asare-21/maame-air/fab/MaameDrone_V1.0_renders.pdf

## MaameDrone V1.0: top

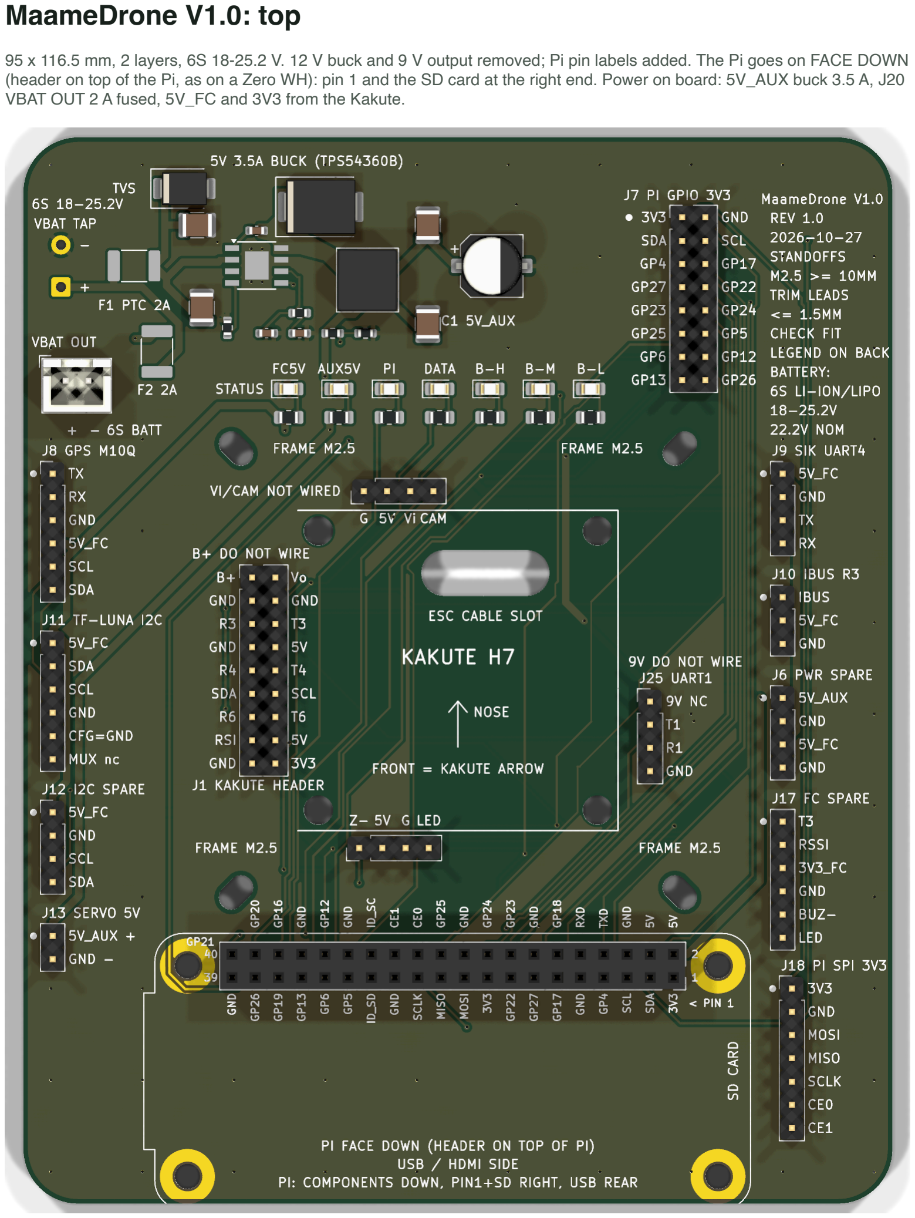
[picture p4: page 1]

95 x 116.5 mm, 2 layers, 6S 18-25.2 V. 12 V buck and 9 V output removed; Pi pin labels added. The Pi goes on FACE DOWN (header on top of the Pi, as on a Zero WH): pin 1 and the SD card at the right end. Power on board: 5V_AUX buck 3.5 A, J20 VBAT OUT 2 A fused, 5V_FC and 3V3 from the Kakute.

## MaameDrone V1.0: 3D view

Parts as fitted by JLCPCB: 5 V buck, status LEDs, Kakute headers, Pi socket.

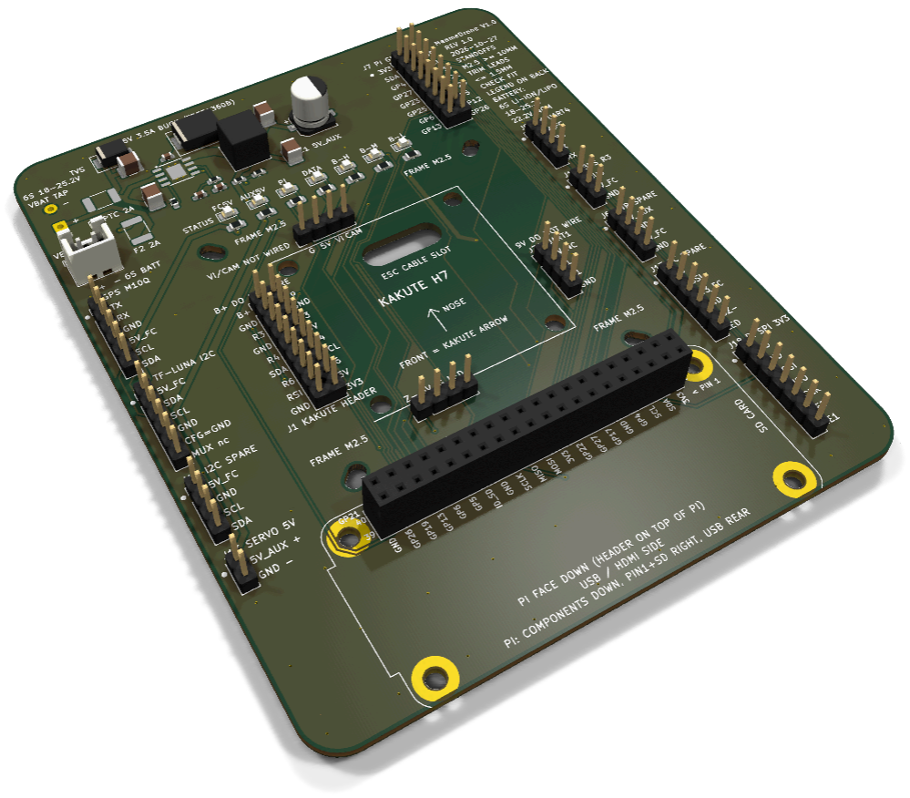
[picture p5: figure]

## MaameDrone V1.0: bottom

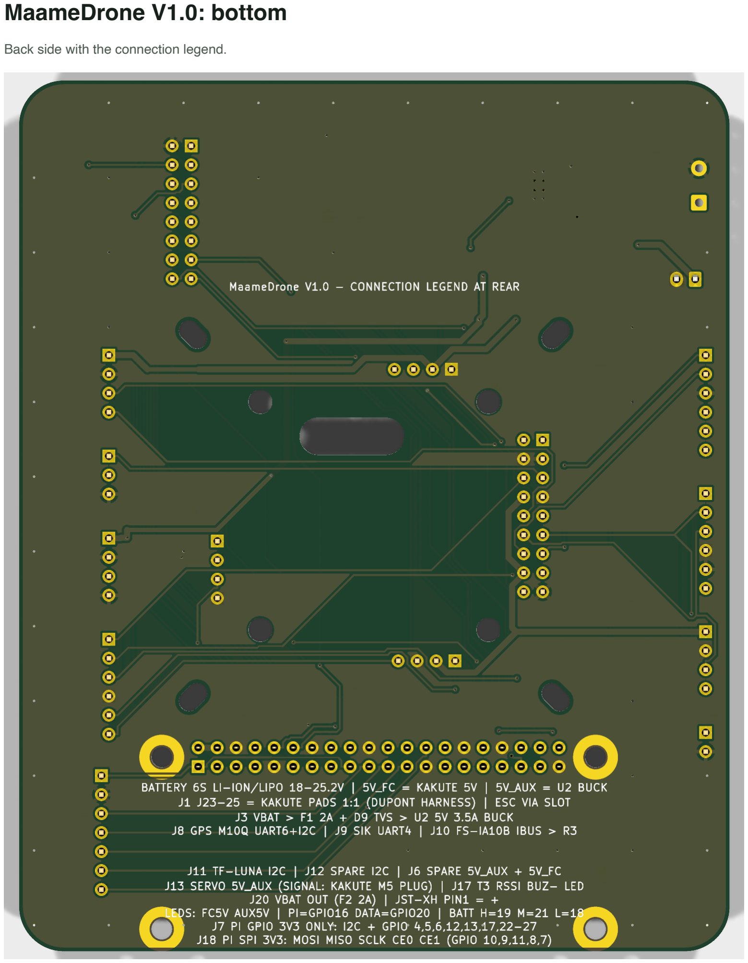
[picture p6: page 3]

Back side with the connection legend.
