asare-21/maame-air/fab/MaameDrone_V1.0_render_3d_angle.png

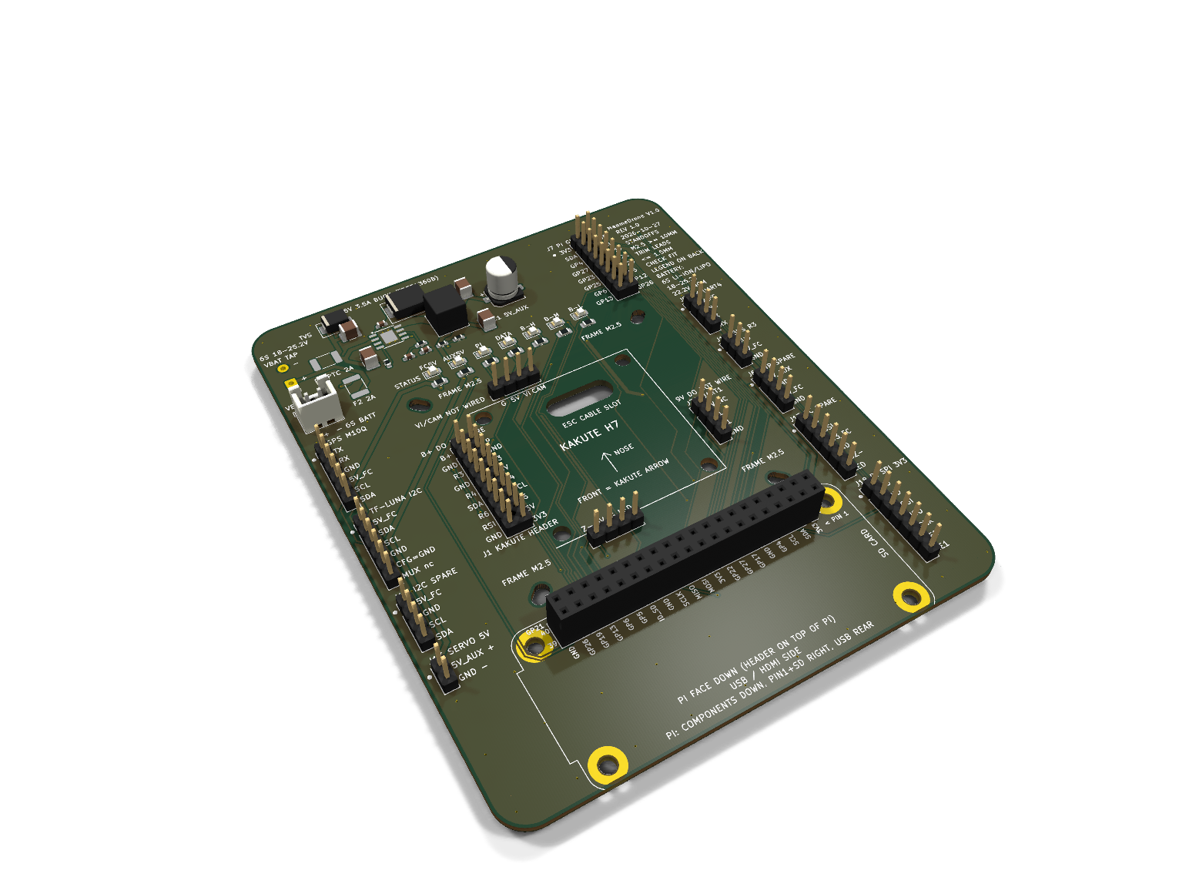
fab/MaameDrone_V1.0_render_3d_angle.png
