asare-21/maame-air/fab/MaameDrone_V1.0_render_bottom.png

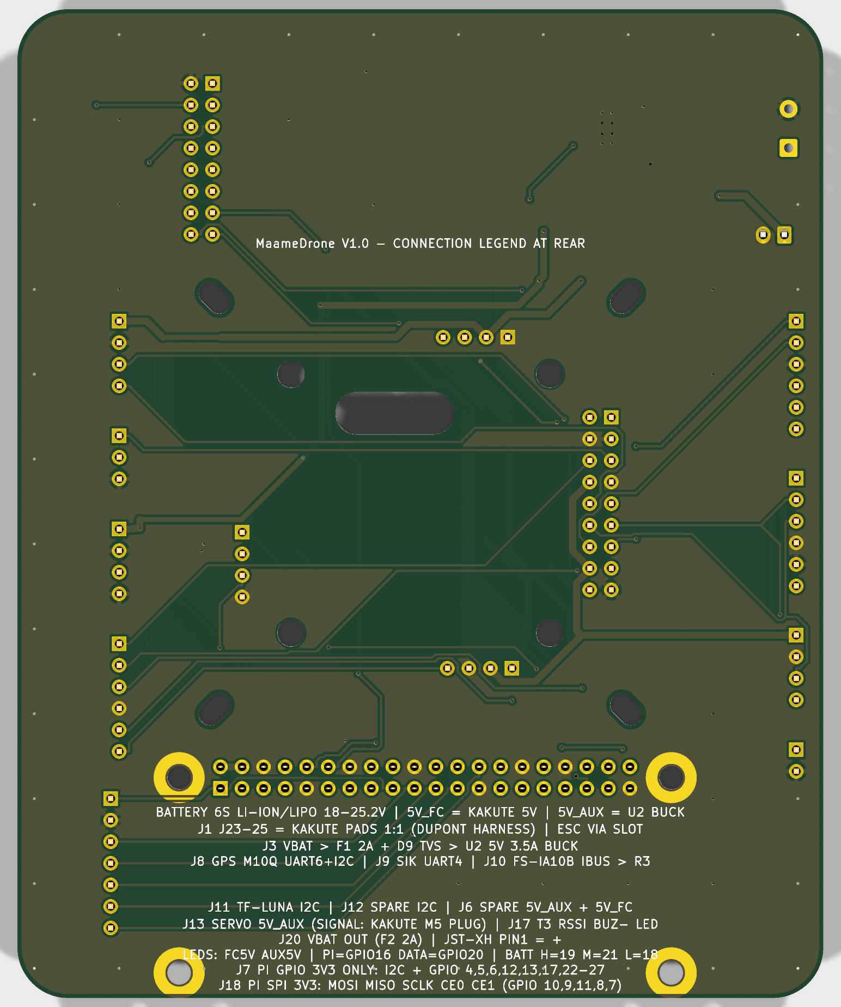
fab/MaameDrone_V1.0_render_bottom.png
