asare-21/maame-air/fab/MaameDrone_V1.0_render_top.png

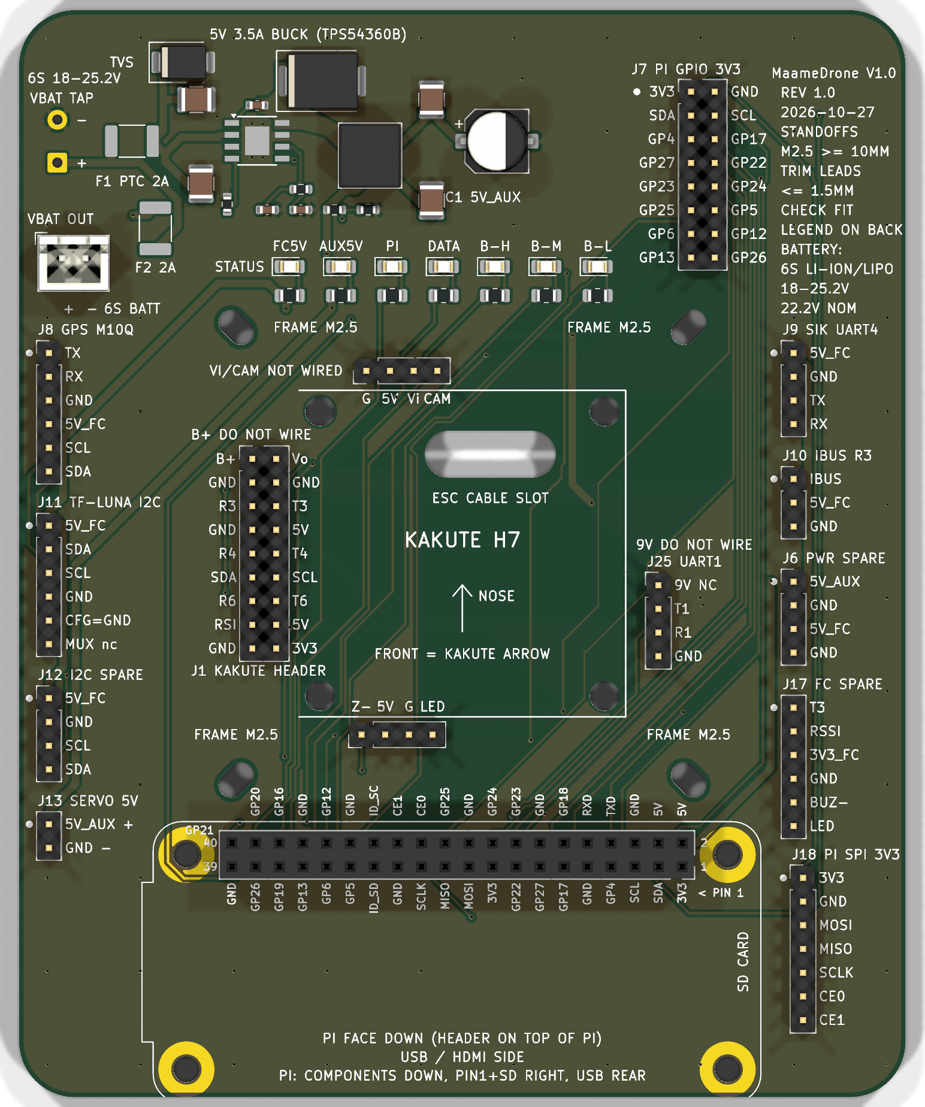
fab/MaameDrone_V1.0_render_top.png
