asare-21/maame-air/maame_carrier_placement_draft.png

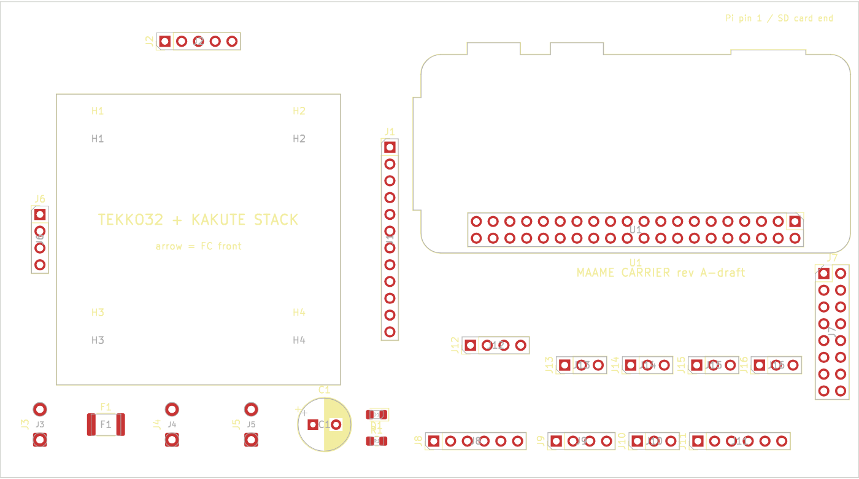
maame_carrier_placement_draft.png
