asare-21/maame-air/fab/MaameDrone_V1.0_BOM_JLC.csv

Comment | Designator | Footprint | LCSC Part #
470uF 16V SMD electrolytic (LCSC C22383803) | C1 | CP_Elec_6.3x7.7 | C22383803
2.2uF 100V X7R 1210 (VIN) | C2,C3 | C_1210_3225Metric | C153036
100nF 50V 0603 (BOOT) | C4 | C_0603_1608Metric | C14663
6.8nF 50V 0603 (COMP) | C5 | C_0603_1608Metric | C1631
47uF 10V X7R 1210 (OUT) | C6,C7 | C_1210_3225Metric | C84494
39pF 50V C0G 0603 (COMP) | C8 | C_0603_1608Metric | C107049
Green 0805: 5V_AUX on | D1,D2,D3,D5 | LED_0805_2012Metric_Pad1.15x1.40mm_HandSolder | C2297
Yellow 0805: data (GPIO20) | D4,D6 | LED_0805_2012Metric_Pad1.15x1.40mm_HandSolder | C2296
Red 0805: battery low (GPIO18) | D7 | LED_0805_2012Metric_Pad1.15x1.40mm_HandSolder | C84256
B560C 60V 5A Schottky SMC | D8 | D_SMC | C85100
SMBJ30A TVS 30V standoff, 48.4V clamp | D9 | D_SMB | C113998
PTC fuse 1812 30V 2A hold 4A trip (BSMD1812-200-30V, LCSC C960026) | F1,F2 | Fuse_1812_4532Metric_Pad1.30x3.40mm_HandSolder | C960026
8.2uH 8.4A Coilcraft XAL6060-822MEC | L1 | L_Coilcraft_XAL6060-XXX | C19191627
1k 0805 | R1,R2 | R_0805_2012Metric_Pad1.20x1.40mm_HandSolder | C17513
330R 0805 | R3,R4,R5,R6 | R_0805_2012Metric_Pad1.20x1.40mm_HandSolder | C17630
390R 0805 | R7 | R_0805_2012Metric_Pad1.20x1.40mm_HandSolder | C17655
162k 1% 0603 (RT, 600 kHz) | R8 | R_0603_1608Metric | C227607
13k 1% 0603 (COMP) | R9 | R_0603_1608Metric | C22797
53.6k 1% 0603 (FB top) | R10 | R_0603_1608Metric | C23074
10k 1% 0603 (FB bottom) | R11 | R_0603_1608Metric | C25804
TPS54360BDDAR 60V 3.5A buck | U2 | TI_SO-PowerPAD-8_ThermalVias | C524806
