asare-21/maame-air/maame_carrier.pdf

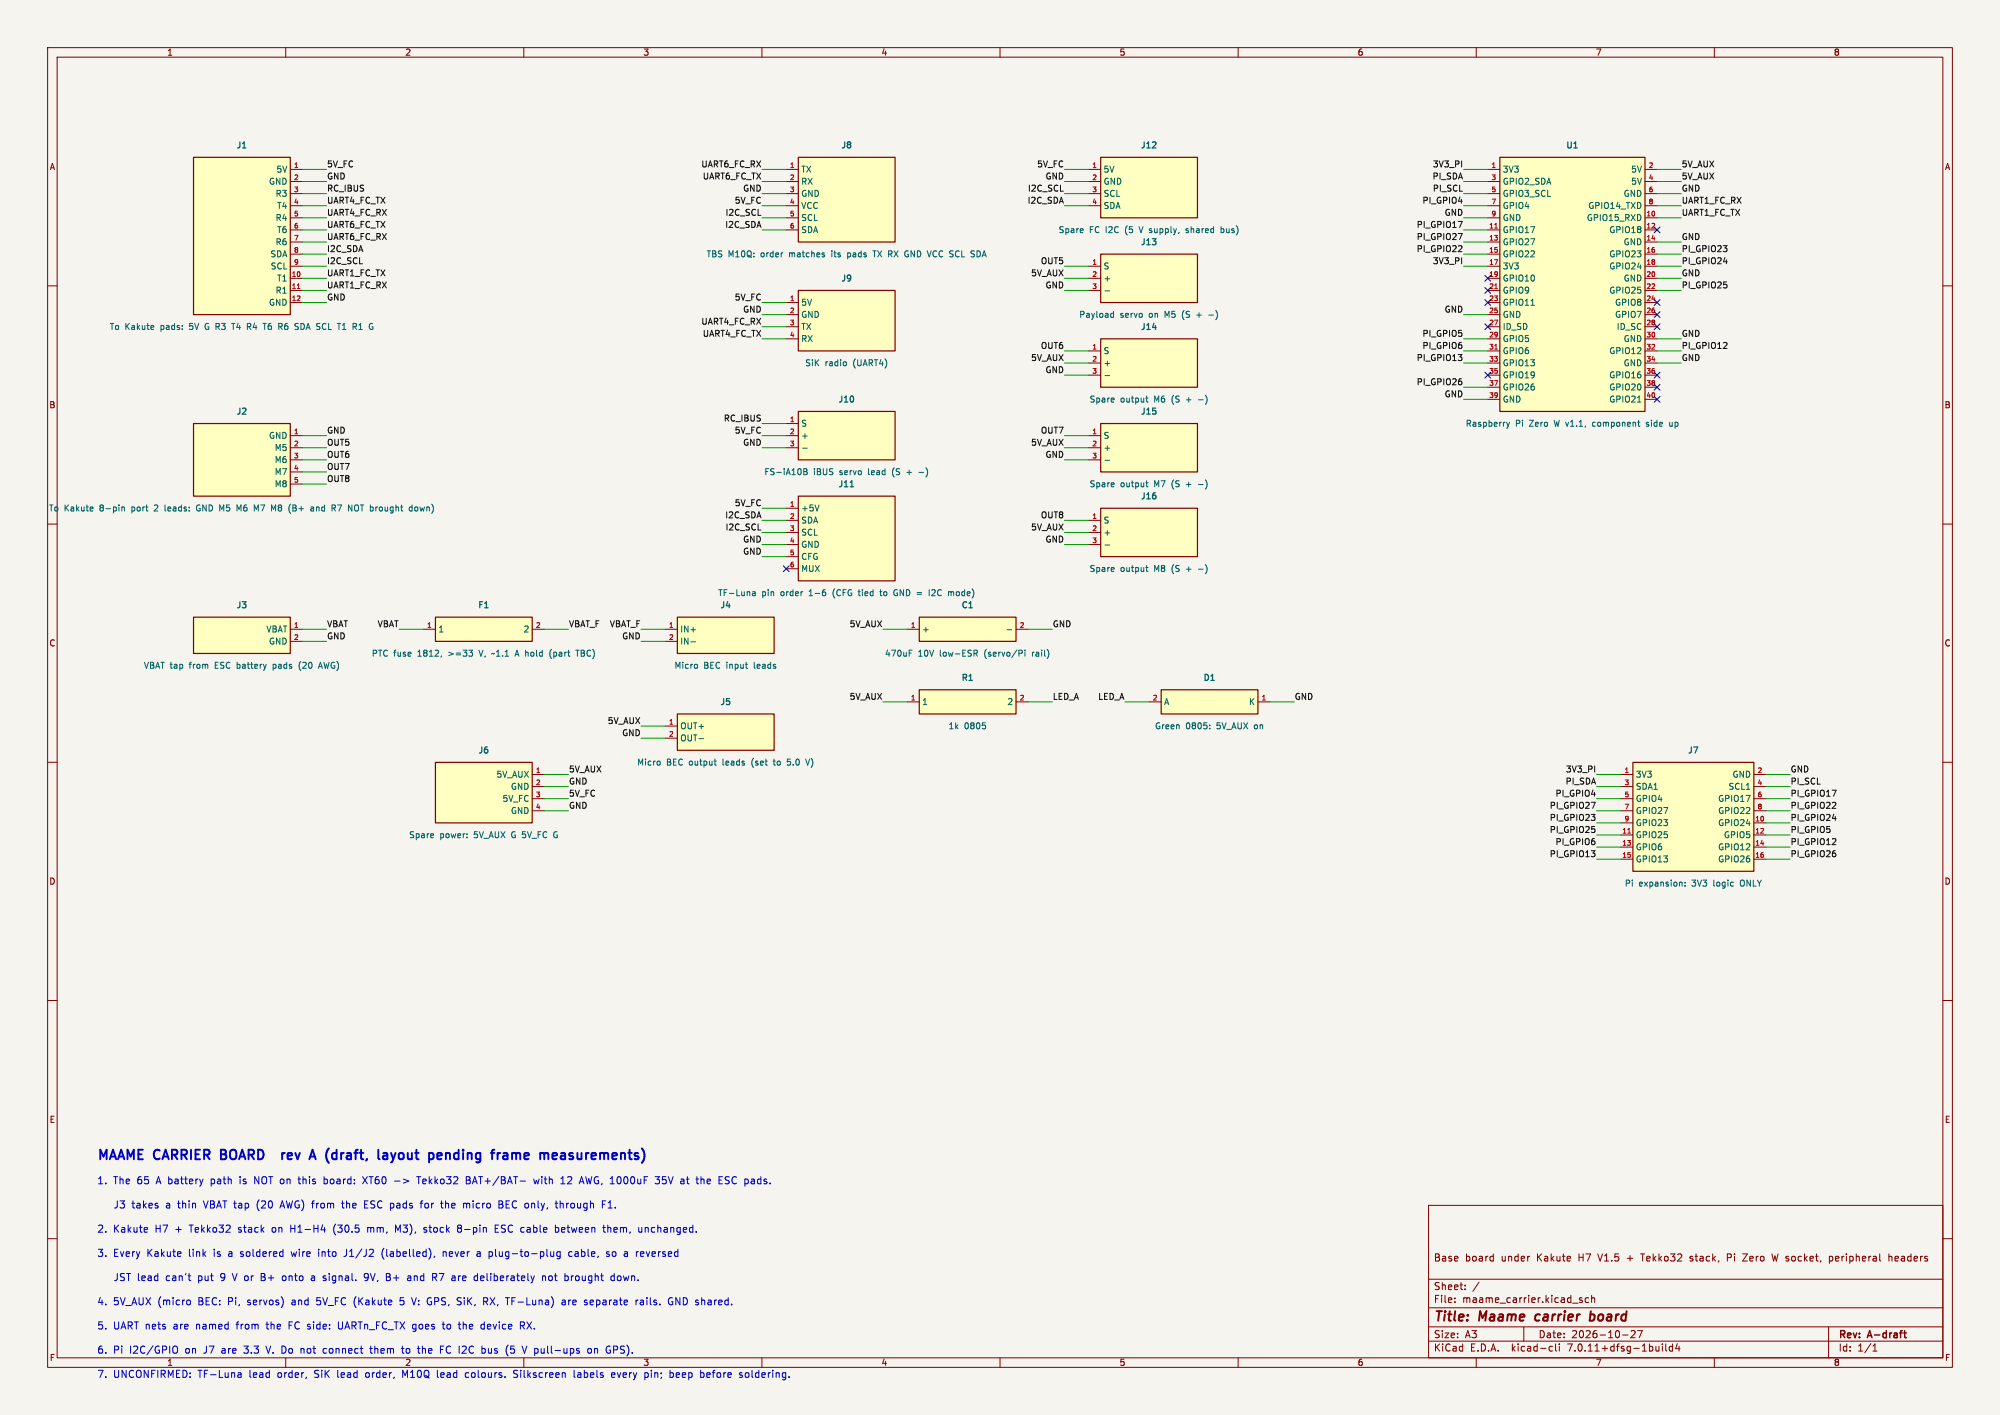
[picture p11: page 1]

5V 1 T1 10 R1 11 GND 12 GND 2 R3 3 T4 4 R4 5 T6 6 R6 7 SDA 8 SCL 9 J1 To Kakute pads: 5V G R3 T4 R4 T6 R6 SDA SCL T1 R1 G

Id: 1/1 Title: Maame carrier board
