asare-21/maame-air/plate_template/maame_carrier_plate_template_1to1.pdf

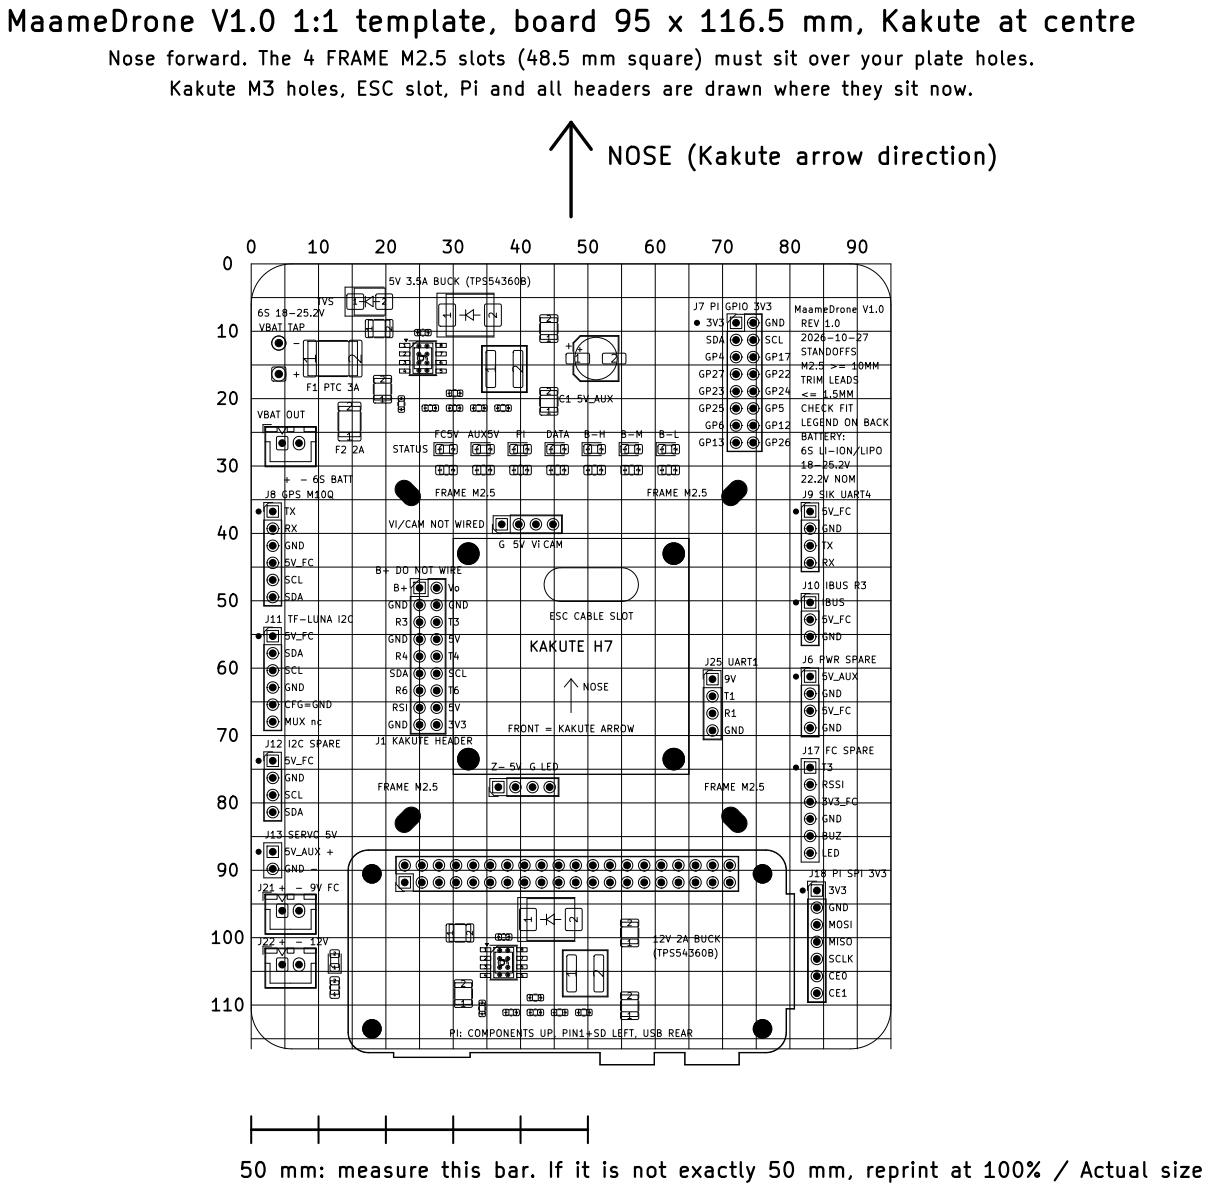
[picture p12: page 1]

MaameDrone V1.0 1:1 template, board 95 x 116.5 mm, Kakute at centre
FC5V 5V 3.5A BUCK (TPS54360B) AUX5VZ-

Nose forward. The 4 FRAME M2.5 slots (48.5 mm square) must sit over your plate holes.
Kakute M3 holes, ESC slot, Pi and all headers are drawn where they sit now.

NOSE (Kakute arrow direction)

F2 | 2A | | | | | | | | | | H7 | | SDA GP4 GP27 GP23 GP25 GP6 GP13 KAKUTE | | BATTERY: 6S LI-ION/LIPO
J8 GPS M10Q | - | | | | FRAME M2.5 | | | | | 2 | FRAME M2.5 | | 4 1 | | 18-25.2V 22.2V NOM J9 SIK UART4

3 4 | 5V_FC | | | | | | 9 1 5V5VPI G G | ESC CABLE SLOT B-H CAM | | | B-M | B-L | FRAME M2.5 | | 3 4 | TXRX

6S BATT TXRXGND | | B+ DO NOT WIRE | VI/CAM NOT | | WIRED | | | | | | | | | | 1 | 5V_FC GND

5 | SCL SDA 5V_FC | | | | | | | | | | | | | | J10 | IBUS R3

1 SDA SCL GND | R4 | 7 8 9 10 | 5V T4 | J25 | UART1 | 3 J6 PWR SPARE

3 4 | | | | SDA R6 RSI GND | 11 12 13 14 | SCL T6 | | | 1 | 9V | | | 1 | 5V_AUX GND

5 6 | CFG=GND MUX nc 5V_FC | | | | 15 16 17 18 | | FRONT = | KAKUTE ARROW | 3 | T1R1GND | | 3 4 | | 5V_FC GND

J12 | I2C SPARE | | J1 | KAKUTE HEADER | | | | | | | J17 | FC SPARE

SCL SDA 5V_AUX + | | | | | | | | | | | | 4 5 | GND BUZ-

GND - | | | | | | | | | | | | | 6 | LED

-9V FC | | | 3 5 | 7 9 | 11 13 | 15 17 | 19 21 | 23 25 | 27 29 | 31 33 | 35 37 | 39 | J18 PI SPI 3V3

2 3 | 3V3 GND MOSI MISO

J22 + | -12V | (TPS54360B) | 4 5 | SCLK

50 mm: measure this bar. If it is not exactly 50 mm, reprint at 100% / Actual size
