asare-21/maame-air/(list of files, drawings)

Other design files:
route/maame_carrier.dsn
