asare-21/maame-air/maame_carrier.kicad_pcb

## KiCad design maame_carrier.kicad_pcb (2026-10-28)

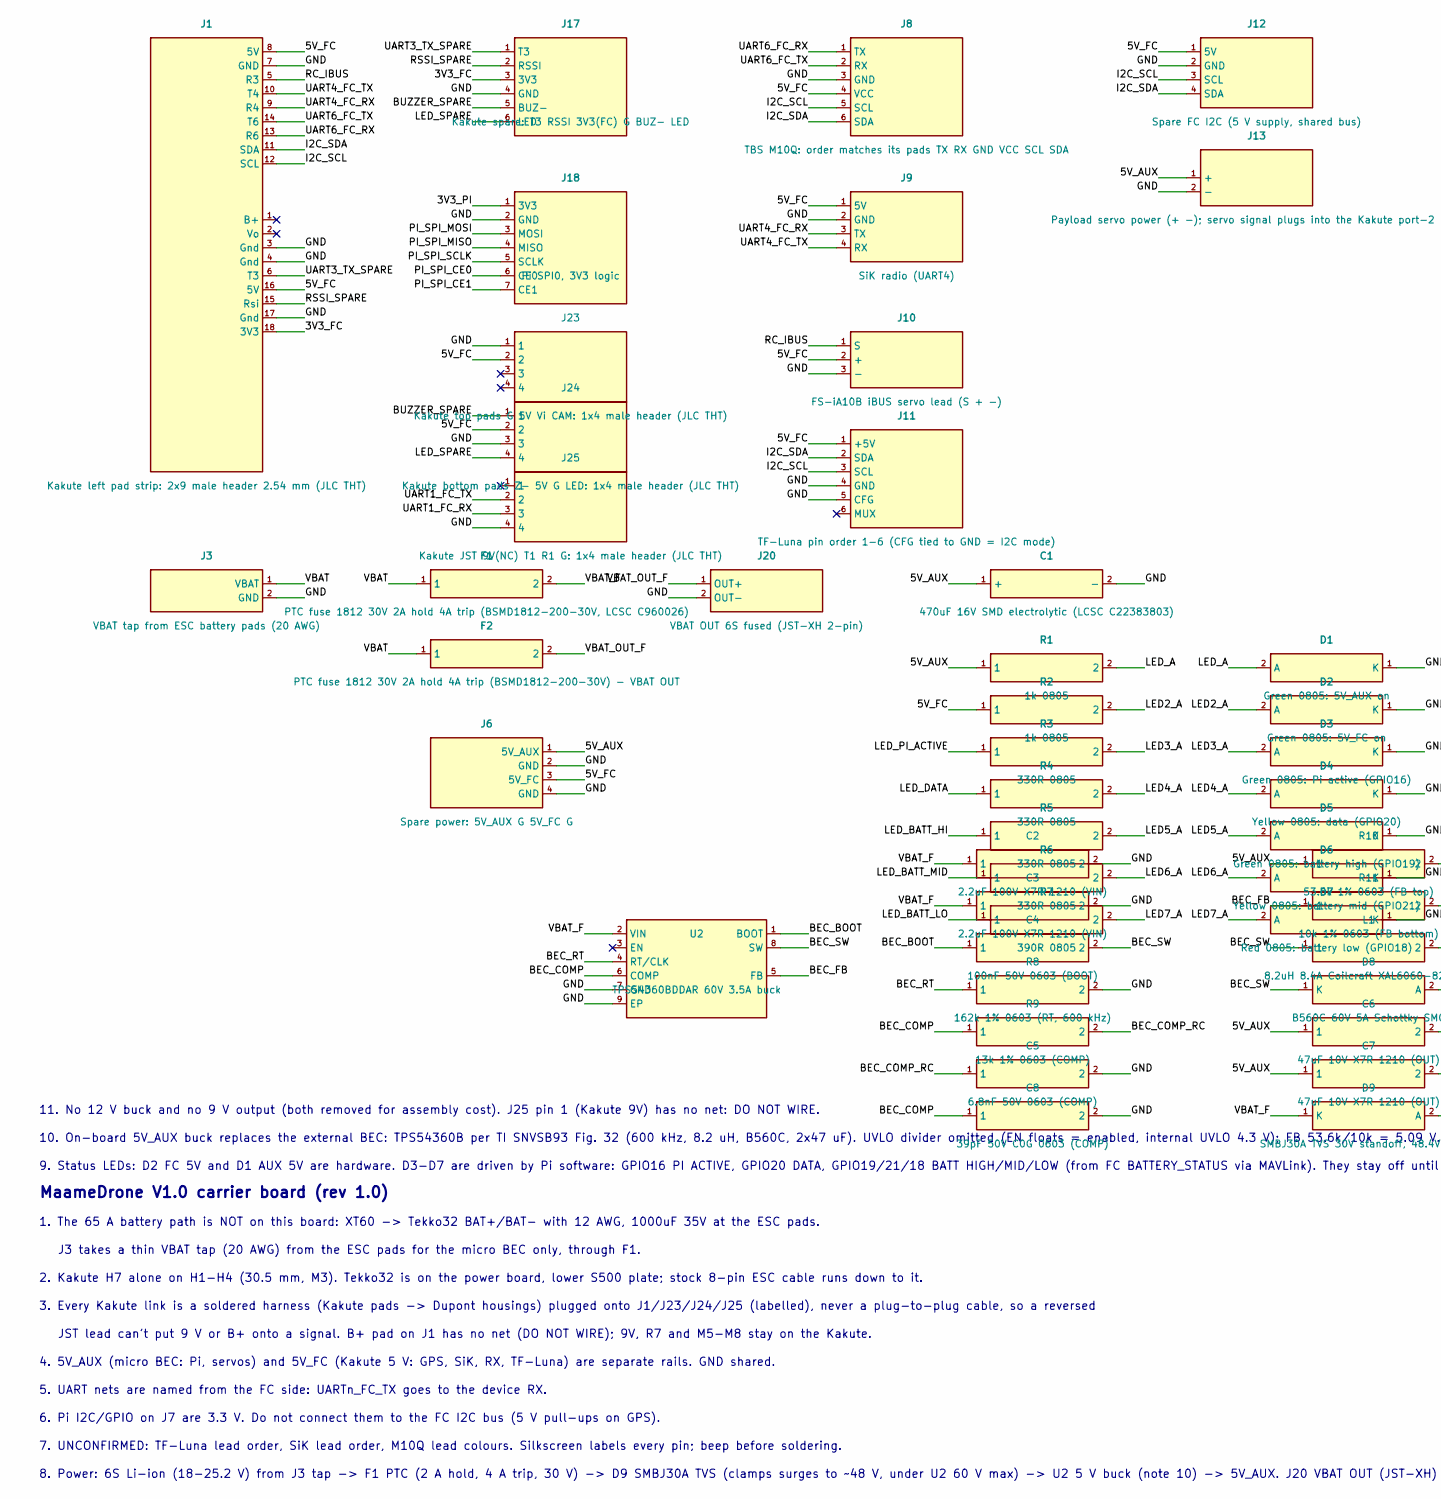
[picture p13: schematic maame_carrier.kicad_sch, MaameDrone V1.0, part in row 1, column 1]

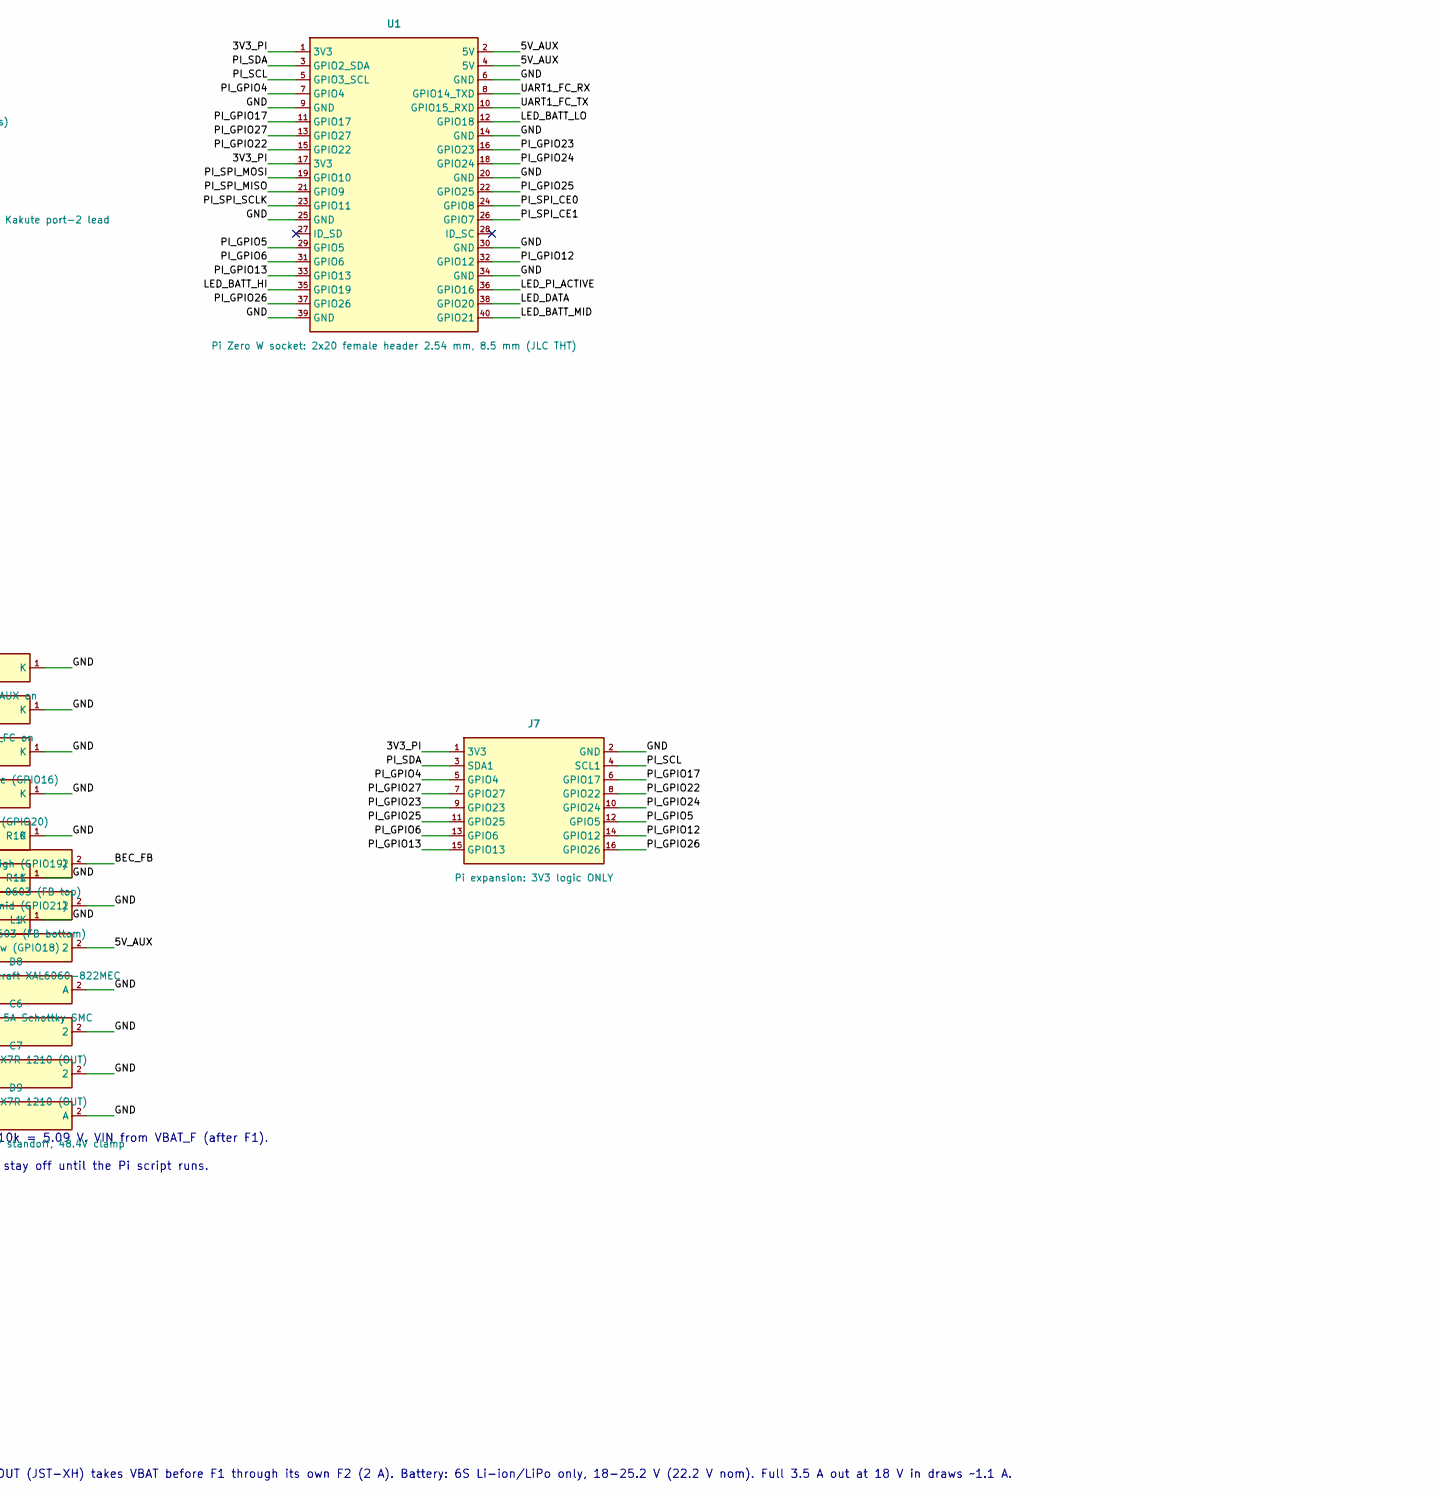
[picture p14: schematic maame_carrier.kicad_sch, MaameDrone V1.0, part in row 1, column 2]

Parts:
C1: 470uF 16V SMD electrolytic (LCSC C22383803); CP_Elec_6.3x7.7; LCSC C22383803
C2, C3: 2.2uF 100V X7R 1210 (VIN); C_1210_3225Metric; LCSC C153036
C4: 100nF 50V 0603 (BOOT); C_0603_1608Metric; LCSC C14663
C5: 6.8nF 50V 0603 (COMP); C_0603_1608Metric; LCSC C1631
C6, C7: 47uF 10V X7R 1210 (OUT); C_1210_3225Metric; LCSC C84494
C8: 39pF 50V C0G 0603 (COMP); C_0603_1608Metric; LCSC C107049
D1: Green 0805: 5V_AUX on; LED_0805_2012Metric_Pad1.15x1.40mm_HandSolder; LCSC C2297
D2: Green 0805: 5V_FC on; LED_0805_2012Metric_Pad1.15x1.40mm_HandSolder; LCSC C2297
D3: Green 0805: Pi active (GPIO16); LED_0805_2012Metric_Pad1.15x1.40mm_HandSolder; LCSC C2297
D4: Yellow 0805: data (GPIO20); LED_0805_2012Metric_Pad1.15x1.40mm_HandSolder; LCSC C2296
D5: Green 0805: battery high (GPIO19); LED_0805_2012Metric_Pad1.15x1.40mm_HandSolder; LCSC C2297
D6: Yellow 0805: battery mid (GPIO21); LED_0805_2012Metric_Pad1.15x1.40mm_HandSolder; LCSC C2296
D7: Red 0805: battery low (GPIO18); LED_0805_2012Metric_Pad1.15x1.40mm_HandSolder; LCSC C84256
D8: B560C 60V 5A Schottky SMC; D_SMC; LCSC C85100
D9: SMBJ30A TVS 30V standoff, 48.4V clamp; D_SMB; LCSC C113998
F1, F2: PTC fuse 1812 30V 2A hold 4A trip (BSMD1812-200-3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; Fuse_1812_4532Metric_Pad1.30x3.40mm_HandSolder; LCSC C960026
J1: Kakute left pad strip: 2x9 male header 2.54 mm (J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; PinHeader_2x09_P2.54mm_Vertical; LCSC C42372517
J3: VBAT tap from ESC battery pads (20 AWG); SolderWire-0.5sqmm_1x02_P4.6mm_D0.9mm_OD2.1mm
J6: Spare power: 5V_AUX G 5V_FC G; PinHeader_1x04_P2.54mm_Vertical
J7: Pi expansion: 3V3 logic ONLY; PinHeader_2x08_P2.54mm_Vertical
J8: TBS M10Q: order matches its pads TX RX GND VCC SC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; PinHeader_1x06_P2.54mm_Vertical
J9: SiK radio (UART4); PinHeader_1x04_P2.54mm_Vertical
J10: FS-iA10B iBUS servo lead (S + -); PinHeader_1x03_P2.54mm_Vertical
J11: TF-Luna pin order 1-6 (CFG tied to GND = I2C mode); PinHeader_1x06_P2.54mm_Vertical
J12: Spare FC I2C (5 V supply, shared bus); PinHeader_1x04_P2.54mm_Vertical
J13: Payload servo power (+ -); servo signal plugs int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; PinHeader_1x02_P2.54mm_Vertical
J17: Kakute spare: T3 RSSI 3V3(FC) G BUZ- LED; PinHeader_1x06_P2.54mm_Vertical
J18: Pi SPI0, 3V3 logic; PinHeader_1x07_P2.54mm_Vertical
J20: VBAT OUT 6S fused (JST-XH 2-pin); JST_XH_B2B-XH-A_1x02_P2.50mm_Vertical
J23: Kakute top pads G 5V Vi CAM: 1x4 male header (JLC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; PinHeader_1x04_P2.54mm_Vertical; LCSC C32713270
J24: Kakute bottom pads Z- 5V G LED: 1x4 male header (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; PinHeader_1x04_P2.54mm_Vertical; LCSC C32713270
J25: Kakute JST 9V(NC) T1 R1 G: 1x4 male header (JLC T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; PinHeader_1x04_P2.54mm_Vertical; LCSC C32713270
L1: 8.2uH 8.4A Coilcraft XAL6060-822MEC; L_Coilcraft_XAL6060-XXX; LCSC C19191627
R1, R2: 1k 0805; R_0805_2012Metric_Pad1.20x1.40mm_HandSolder; LCSC C17513
R3, R4, R5, R6: 330R 0805; R_0805_2012Metric_Pad1.20x1.40mm_HandSolder; LCSC C17630
R7: 390R 0805; R_0805_2012Metric_Pad1.20x1.40mm_HandSolder; LCSC C17655
R8: 162k 1% 0603 (RT, 600 kHz); R_0603_1608Metric; LCSC C227607
R9: 13k 1% 0603 (COMP); R_0603_1608Metric; LCSC C22797
R10: 53.6k 1% 0603 (FB top); R_0603_1608Metric; LCSC C23074
R11: 10k 1% 0603 (FB bottom); R_0603_1608Metric; LCSC C25804
U1: Pi Zero W socket: 2x20 female header 2.54 mm, 8.5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; Pi_Zero_Socketed_FaceDown_MountingHoles; LCSC C5124634
U2: TPS54360BDDAR 60V 3.5A buck; TI_SO-PowerPAD-8_ThermalVias; LCSC C524806

Connections:
/3V3_FC: J1.18 (3V3), J17.3 (3V3)
/3V3_PI: J7.1 (3V3), J18.1 (3V3), U1.1 (3V3), U1.17 (3V3)
/5V_AUX: C1.1 (+), C6.1, C7.1, J6.1 (5V_AUX), J13.1 (+), L1.2, R1.1, R10.1, U1.2 (5V), U1.4 (5V)
/5V_FC: J1.8 (5V), J1.16 (5V), J6.3 (5V_FC), J8.4 (VCC), J9.1 (5V), J10.2 (+), J11.1 (+5V), J12.1 (5V), J23.2, J24.2, R2.1
/BEC_BOOT: C4.1, U2.1 (BOOT)
/BEC_COMP: C8.1, R9.1, U2.6 (COMP)
/BEC_COMP_RC: C5.1, R9.2
/BEC_FB: R10.2, R11.1, U2.5 (FB)
/BEC_RT: R8.1, U2.4 (RT/CLK)
/BEC_SW: C4.2, D8.1 (K), L1.1, U2.8 (SW)
/BUZZER_SPARE: J17.5 (BUZ-), J24.1
/GND: C1.2 (-), C2.2, C3.2, C5.2, C6.2, C7.2, C8.2, D1.1 (K), D2.1 (K), D3.1 (K), D4.1 (K), D5.1 (K), D6.1 (K), D7.1 (K), D8.2 (A), D9.2 (A), J1.3 (Gnd), J1.4 (Gnd), J1.7 (GND), J1.17 (Gnd), J3.2 (GND), J6.2 (GND), J6.4 (GND), J7.2 (GND), J8.3 (GND), J9.2 (GND), J10.3 (-), J11.4 (GND), J11.5 (CFG), J12.2 (GND), J13.2 (-), J17.4 (GND), J18.2 (GND), J20.2 (OUT-), J23.1, J24.3, J25.4, R8.2, R11.2, U1.6 (GND), U1.9 (GND), U1.14 (GND), U1.20 (GND), U1.25 (GND), U1.30 (GND), U1.34 (GND), U1.39 (GND), U2.7 (GND), U2.9 (EP)
/I2C_SCL: J1.12 (SCL), J8.5 (SCL), J11.3 (SCL), J12.3 (SCL)
/I2C_SDA: J1.11 (SDA), J8.6 (SDA), J11.2 (SDA), J12.4 (SDA)
/LED2_A: D2.2 (A), R2.2
/LED3_A: D3.2 (A), R3.2
/LED4_A: D4.2 (A), R4.2
/LED5_A: D5.2 (A), R5.2
/LED6_A: D6.2 (A), R6.2
/LED7_A: D7.2 (A), R7.2
/LED_A: D1.2 (A), R1.2
/LED_BATT_HI: R5.1, U1.35 (GPIO19)
/LED_BATT_LO: R7.1, U1.12 (GPIO18)
/LED_BATT_MID: R6.1, U1.40 (GPIO21)
/LED_DATA: R4.1, U1.38 (GPIO20)
/LED_PI_ACTIVE: R3.1, U1.36 (GPIO16)
/LED_SPARE: J17.6 (LED), J24.4
/PI_GPIO4: J7.5 (GPIO4), U1.7 (GPIO4)
/PI_GPIO5: J7.12 (GPIO5), U1.29 (GPIO5)
/PI_GPIO6: J7.13 (GPIO6), U1.31 (GPIO6)
/PI_GPIO12: J7.14 (GPIO12), U1.32 (GPIO12)
/PI_GPIO13: J7.15 (GPIO13), U1.33 (GPIO13)
/PI_GPIO17: J7.6 (GPIO17), U1.11 (GPIO17)
/PI_GPIO22: J7.8 (GPIO22), U1.15 (GPIO22)
/PI_GPIO23: J7.9 (GPIO23), U1.16 (GPIO23)
/PI_GPIO24: J7.10 (GPIO24), U1.18 (GPIO24)
/PI_GPIO25: J7.11 (GPIO25), U1.22 (GPIO25)
/PI_GPIO26: J7.16 (GPIO26), U1.37 (GPIO26)
/PI_GPIO27: J7.7 (GPIO27), U1.13 (GPIO27)
/PI_SCL: J7.4 (SCL1), U1.5 (GPIO3_SCL)
/PI_SDA: J7.3 (SDA1), U1.3 (GPIO2_SDA)
/PI_SPI_CE0: J18.6 (CE0), U1.24 (GPIO8)
/PI_SPI_CE1: J18.7 (CE1), U1.26 (GPIO7)
/PI_SPI_MISO: J18.4 (MISO), U1.21 (GPIO9)
/PI_SPI_MOSI: J18.3 (MOSI), U1.19 (GPIO10)
/PI_SPI_SCLK: J18.5 (SCLK), U1.23 (GPIO11)
/RC_IBUS: J1.5 (R3), J10.1 (S)
/RSSI_SPARE: J1.15 (Rsi), J17.2 (RSSI)
/UART1_FC_RX: J25.3, U1.8 (GPIO14_TXD)
/UART1_FC_TX: J25.2, U1.10 (GPIO15_RXD)
/UART3_TX_SPARE: J1.6 (T3), J17.1 (T3)
/UART4_FC_RX: J1.9 (R4), J9.3 (TX)
/UART4_FC_TX: J1.10 (T4), J9.4 (RX)
/UART6_FC_RX: J1.13 (R6), J8.1 (TX)
/UART6_FC_TX: J1.14 (T6), J8.2 (RX)
/VBAT: F1.1, F2.1, J3.1 (VBAT)
/VBAT_F: C2.1, C3.1, D9.1 (K), F1.2, U2.2 (VIN)
/VBAT_OUT_F: F2.2, J20.1 (OUT+)

Notes on the sheet:
J3 takes a thin VBAT tap (20 AWG) from the ESC pads for the micro BEC only, through F1.
MaameDrone V1.0 carrier board (rev 1.0)
5. UART nets are named from the FC side: UARTn_FC_TX goes to the device RX.
6. Pi I2C/GPIO on J7 are 3.3 V. Do not connect them to the FC I2C bus (5 V pull-ups on GPS).
3. Every Kakute link is a soldered harness (Kakute pads -> Dupont housings) plugged onto J1/J23/J24/J25 (labelled), never a plug-to-plug cable, so a reversed
1. The 65 A battery path is NOT on this board: XT60 -> Tekko32 BAT+/BAT- with 12 AWG, 1000uF 35V at the ESC pads.
4. 5V_AUX (micro BEC: Pi, servos) and 5V_FC (Kakute 5 V: GPS, SiK, RX, TF-Luna) are separate rails. GND shared.
8. Power: 6S Li-ion (18-25.2 V) from J3 tap -> F1 PTC (2 A hold, 4 A trip, 30 V) -> D9 SMBJ30A TVS (clamps surges to ~48 V, under U2 60 V max) -> U2 5 V buck (note 10) -> 5V_AUX. J20 VBAT OUT (JST-XH) takes VBAT before F1 through its own F2 (2 A). Battery: 6S Li-ion/LiPo only, 18-25.2 V (22.2 V nom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
7. UNCONFIRMED: TF-Luna lead order, SiK lead order, M10Q lead colours. Silkscreen labels every pin; beep before soldering.
2. Kakute H7 alone on H1-H4 (30.5 mm, M3). Tekko32 is on the power board, lower S500 plate; stock 8-pin ESC cable runs down to it.
JST lead can't put 9 V or B+ onto a signal. B+ pad on J1 has no net (DO NOT WIRE); 9V, R7 and M5-M8 stay on the Kakute.
9. Status LEDs: D2 FC 5V and D1 AUX 5V are hardware. D3-D7 are driven by Pi software: GPIO16 PI ACTIVE, GPIO20 DATA, GPIO19/21/18 BATT HIGH/MID/LOW (from FC BATTERY_STATUS via MAVLink). They stay off until the Pi script runs.
10. On-board 5V_AUX buck replaces the external BEC: TPS54360B per TI SNVSB93 Fig. 32 (600 kHz, 8.2 uH, B560C, 2x47 uF). UVLO divider omitted (EN floats = enabled, internal UVLO 4.3 V); FB 53.6k/10k = 5.09 V. VIN from VBAT_F (after F1).
11. No 12 V buck and no 9 V output (both removed for assembly cost). J25 pin 1 (Kakute 9V) has no net: DO NOT WIRE.

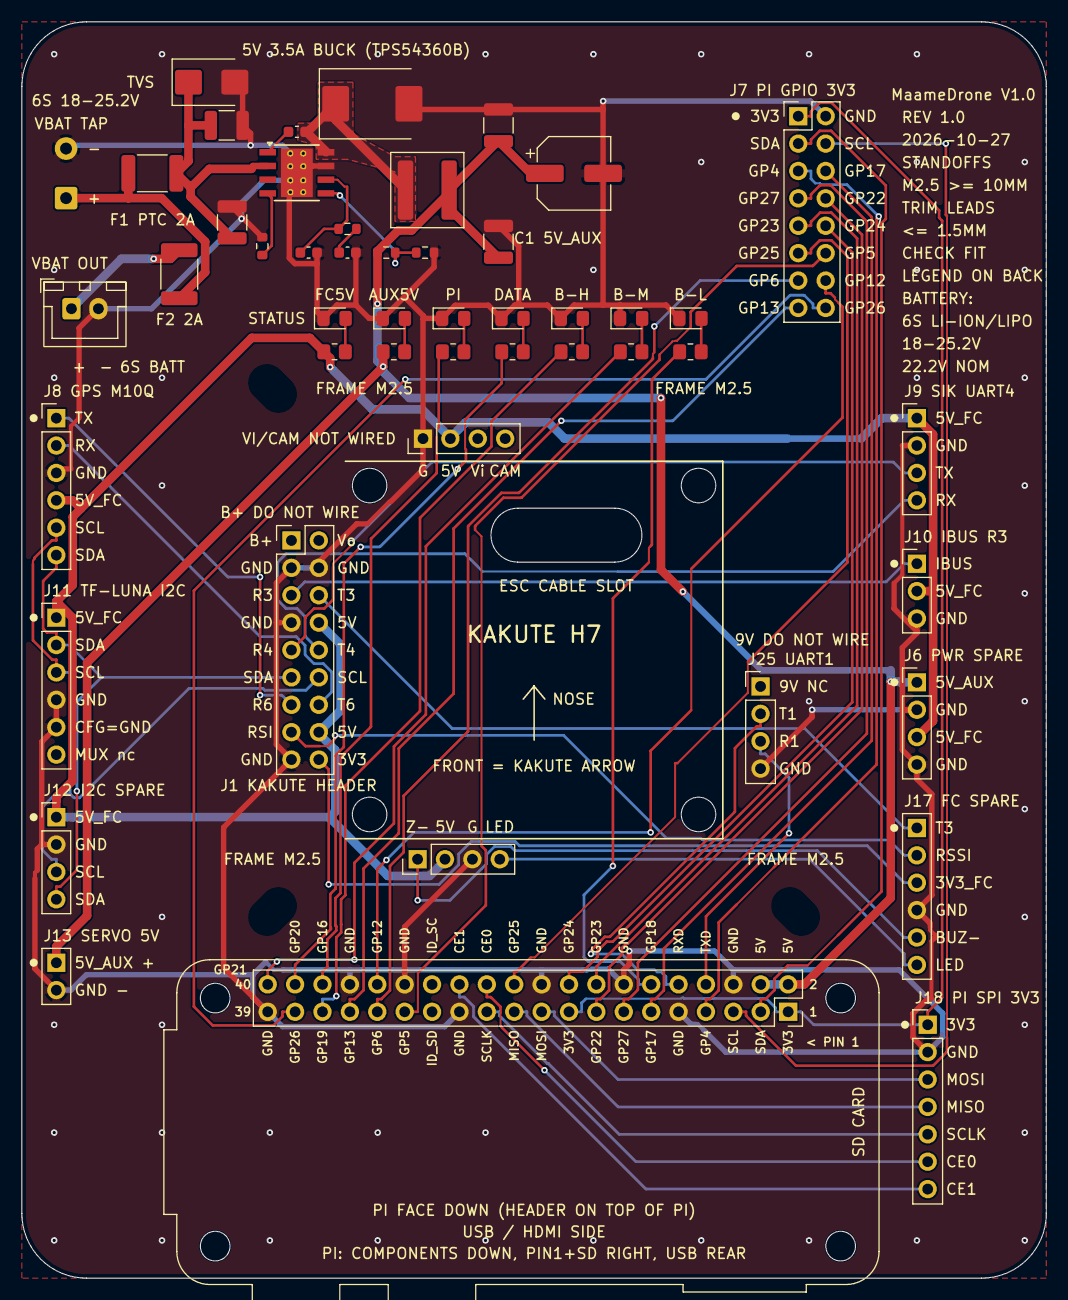
[picture p15: board maame_carrier.kicad_pcb from above]

Board: 2 copper layers, 95.0 x 116.5 mm, 57 parts (0 on the bottom side), 58 nets.

Other parts of the board:
H1, H2, H3, H4: M3 FC hole; MountingHole_3.2mm_M3
H5, H6, H7, H8: M2.5 frame mount, 48.5 mm square, radial slot; MountingHole_2.7mm_M2.5
