asare-21/maame-air/sitl/params/maame.parm

# Maame safety baseline (renderer/maame/safety-baseline.ts) + Pi gate
ARMING_SKIPCHK 64
FS_THR_ENABLE 0
FS_GCS_ENABLE 1
FS_GCS_TIMEOUT 5
FS_OPTIONS 10
FS_EKF_ACTION 1
AUTO_OPTIONS 3
FENCE_ENABLE 1
FENCE_TYPE 7
FENCE_ACTION 1
FENCE_ALT_MAX 120
FENCE_RADIUS 150
BATT_FS_LOW_ACT 2
BATT_FS_CRT_ACT 1
SCR_ENABLE 1
SCR_USER1 0
SCR_USER2 1
MAV_GCS_SYSID 255
