asare-21/maame-air/(commit log)

2026-10-27 Carrier board draft as received (KiCad 10 format)
    [maame_carrier.kicad_pcb, maame_carrier.kicad_sch]
2026-10-27 ESC off the carrier: FC-only 35x35 keep-out, relabel, update notes
    [maame_carrier.kicad_pcb, maame_carrier.kicad_sch]
2026-10-27 Add 14x5 mm ESC cable slot at FC centre; shrink FC silk box to 35x35
    [maame_carrier.kicad_pcb]
2026-10-27 Front is set by the Kakute's own arrow; drop the undrawn carrier arrow note
    [maame_carrier.kicad_pcb]
2026-10-27 Kakute pad rows follow the V1.5 pad map: 9 pads by its left strip, T1/R1/G by its JST, J2 by port 2; per-pin labels
    [maame_carrier.kicad_pcb, maame_carrier.kicad_sch]
2026-10-27 Compact placement into 95x95 placeholder: Kakute group top-left, power row, Pi along bottom edge, headers right
    [maame_carrier.kicad_pcb]
2026-10-27 Add 1:1 printable plate template (A4 landscape) and its generator
2026-10-27 J1 mirrors the full Kakute V1.5 left strip (2x9, B+ unwired) + T1/R1/G; drop M5-M8 (J2, J14-J16); J13 -> servo power; add J17 Kakute spare (T3, RSSI, 3V3)
    [maame_carrier.kicad_pcb, maame_carrier.kicad_sch]
2026-10-27 Silkscreen pass: every pin named, connector titles, pin-1 dots, polarity, rails, nose arrow, Pi orientation, board id; headers vertical
    [maame_carrier.kicad_pcb]
2026-10-27 Regenerate plate template for current layout
2026-10-27 Reserve 18x15 mm micro BEC box between J4/J5 (no reverse protection warning); re-space power row; BEC schematic note
    [maame_carrier.kicad_pcb, maame_carrier.kicad_sch]
2026-10-27 Schematic note: 6S Li-ion BEC input current vs F1 margin
    [maame_carrier.kicad_sch]
2026-10-27 J1 mirrors the Kakute's top (G 5V Vi CAM) and bottom (Z- 5V G LED) pad rows; J17 gains BUZ- and LED; J13 under J12; template and render refreshed
    [maame_carrier.kicad_pcb, maame_carrier.kicad_sch]
2026-10-27 Frame mounting: 4x M2.5 (2.7 mm NPTH) on a 50 mm square centred on the Kakute; layout shifted, board 95x110; template updated
    [maame_carrier.kicad_pcb]
2026-10-27 Frame holes measured from the pierced template: 48.3 mm square (was 50), M2.5 radial slots with +/-0.75 mm play
    [maame_carrier.kicad_pcb]
2026-10-27 Frame holes to measured 48.5 mm square (M2.5 radial slots kept)
    [maame_carrier.kicad_pcb]
2026-10-27 Silkscreen: standoff >= 10 mm and lead-trim note
    [maame_carrier.kicad_pcb]
2026-10-27 Centre the board on the Kakute: FC = frame-square centre = outline centre (95 x 111); power + J7 front, headers on both sides, Pi across the rear
    [maame_carrier.kicad_pcb]
2026-10-27 Pi turned so USB/HDMI overhang the rear edge; rear frame screws clear of the Pi; board 95 x 116.5, still centred on the Kakute
    [maame_carrier.kicad_pcb]
2026-10-27 Rounded 3 mm corners; status LED row: FC5V, AUX5V (hardware), PI/DATA/BATT H-M-L on Pi GPIO16/20/19/21/18
    [maame_carrier.kicad_pcb, maame_carrier.kicad_sch]
2026-10-27 Fab prep: JLC design rules + Power/VBAT net classes; board nets synced to schematic (0 parity issues); THT headers/Pi socket DNP, wire pads out of BOM; frame holes board-only
    [maame_carrier.kicad_pcb, maame_carrier.kicad_sch]
2026-10-27 C1 -> SMD 470uF 16V 6.3x7.7 (LCSC C22383803); LCSC fields on all assembled parts
    [maame_carrier.kicad_pcb, maame_carrier.kicad_sch]
2026-10-27 Routed with Freerouting (edge/slot keep-outs, power classes), GND pours both layers with 10 mm stitching; DRC 0 errors, 0 unconnected, parity clean
    [maame_carrier.dsn, maame_carrier.kicad_pcb]
2026-10-27 JLCPCB package in fab/: Gerbers + Excellon (zip), BOM and CPL CSVs, top/bottom renders; F1 set to TECHFUSE mSMD110-33V (C70119)
    [maame_carrier-B_Cu.gbl, maame_carrier-B_Mask.gbs, maame_carrier-B_Paste.gbp, maame_carrier-B_Silkscreen.gbo, maame_carrier-Edge_Cuts.gm1, maame_carrier-F_Cu.gtl, maame_carrier-F_Mask.gts, maame_carrier-F_Paste.gtp]
2026-10-27 ESC cable slot moved 10.65 mm toward the nose and 3 mm right, under the Kakute ESC connector; re-routed, DRC 0 errors; fab files regenerated
    [maame_carrier-B_Cu.gbl, maame_carrier-B_Mask.gbs, maame_carrier-B_Paste.gbp, maame_carrier-B_Silkscreen.gbo, maame_carrier-Edge_Cuts.gm1, maame_carrier-F_Cu.gtl, maame_carrier-F_Mask.gts, maame_carrier-F_Paste.gtp]
2026-10-27 6 mm corner radius; connection legend on the back silkscreen (+ 'LEGEND ON BACK' on top); fab files regenerated
    [maame_carrier-B_Cu.gbl, maame_carrier-B_Mask.gbs, maame_carrier-B_Paste.gbp, maame_carrier-B_Silkscreen.gbo, maame_carrier-Edge_Cuts.gm1, maame_carrier-F_Cu.gtl, maame_carrier-F_Mask.gts, maame_carrier-F_Paste.gtp]
2026-10-27 J18 Pi SPI header (3V3 GND MOSI MISO SCLK CE0 CE1); re-routed; DRC 0 errors; fab files regenerated
    [maame_carrier-B_Cu.gbl, maame_carrier-B_Mask.gbs, maame_carrier-B_Paste.gbp, maame_carrier-B_Silkscreen.gbo, maame_carrier-Edge_Cuts.gm1, maame_carrier-F_Cu.gtl, maame_carrier-F_Mask.gts, maame_carrier-F_Paste.gtp]
2026-10-27 On-board 5V 3.5A buck (TPS54360B, TI Fig.32 values) replaces the external BEC and J4/J5; SW node as copper zone; re-routed, DRC 0 errors; fab files regenerated
    [maame_carrier-B_Cu.gbl, maame_carrier-B_Mask.gbs, maame_carrier-B_Paste.gbp, maame_carrier-B_Silkscreen.gbo, maame_carrier-Edge_Cuts.gm1, maame_carrier-F_Cu.gtl, maame_carrier-F_Mask.gts, maame_carrier-F_Paste.gtp]
2026-10-27 F1 -> 2 A hold / 30 V PTC (BSMD1812-200-30V, C960026) so the on-board buck can deliver its full 3.5 A; notes and fab files updated
    [maame_carrier-B_Cu.gbl, maame_carrier-B_Mask.gbs, maame_carrier-B_Paste.gbp, maame_carrier-B_Silkscreen.gbo, maame_carrier-Edge_Cuts.gm1, maame_carrier-F_Cu.gtl, maame_carrier-F_Mask.gts, maame_carrier-F_Paste.gtp]
2026-10-27 D9 SMBJ30A TVS (C113998) on fused VBAT at the buck input; re-routed, DRC 0 errors; fab files regenerated
    [maame_carrier-B_Cu.gbl, maame_carrier-B_Mask.gbs, maame_carrier-B_Paste.gbp, maame_carrier-B_Silkscreen.gbo, maame_carrier-Edge_Cuts.gm1, maame_carrier-F_Cu.gtl, maame_carrier-F_Mask.gts, maame_carrier-F_Paste.gtp]
2026-10-27 Battery labels (6S Li-ion/LiPo 18-25.2 V); J20 VBAT OUT JST-XH via its own F2 2 A PTC; re-routed, DRC 0 errors; fab files regenerated
    [maame_carrier-B_Cu.gbl, maame_carrier-B_Mask.gbs, maame_carrier-B_Paste.gbp, maame_carrier-B_Silkscreen.gbo, maame_carrier-Edge_Cuts.gm1, maame_carrier-F_Cu.gtl, maame_carrier-F_Mask.gts, maame_carrier-F_Paste.gtp]
2026-10-27 Move F2 label clear of F1 label; fab regenerated
    [maame_carrier-B_Cu.gbl, maame_carrier-B_Mask.gbs, maame_carrier-B_Paste.gbp, maame_carrier-B_Silkscreen.gbo, maame_carrier-Edge_Cuts.gm1, maame_carrier-F_Cu.gtl, maame_carrier-F_Mask.gts, maame_carrier-F_Paste.gtp]
2026-10-27 12 V 2 A on-board buck (U3, TPS54360B) + 12V LED, J21 9V OUT (Kakute VTX 9V via J1 pad 30), J22 12V OUT; F1 -> 3 A/30 V 2920; Pi courtyard limited to socket+standoffs; DSN class patch fixed; re-route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
    [maame_carrier-B_Cu.gbl, maame_carrier-B_Mask.gbs, maame_carrier-B_Paste.gbp, maame_carrier-B_Silkscreen.gbo, maame_carrier-Edge_Cuts.gm1, maame_carrier-F_Cu.gtl, maame_carrier-F_Mask.gts, maame_carrier-F_Paste.gtp]
2026-10-27 Kakute connections as JLC-fitted 2.54 mm male headers (J1 2x9, J23/J24/J25 1x4) on the old pad positions; harness + assembly notes; re-routed, DRC 0 errors; fab regenerated incl. THT in CPL
    [maame_carrier-B_Cu.gbl, maame_carrier-B_Mask.gbs, maame_carrier-B_Paste.gbp, maame_carrier-B_Silkscreen.gbo, maame_carrier-Edge_Cuts.gm1, maame_carrier-F_Cu.gtl, maame_carrier-F_Mask.gts, maame_carrier-F_Paste.gtp]
2026-10-27 fab/ASSEMBLY_NOTES.md: harness, power, mechanical and bring-up notes
2026-10-27 Pi socket U1 (2x20 female 2.54 mm, 8.5 mm, C5124634) JLC-fitted; CPL uses pad centres for THT headers; assembly notes updated
    [maame_carrier-B_Cu.gbl, maame_carrier-B_Mask.gbs, maame_carrier-B_Paste.gbp, maame_carrier-B_Silkscreen.gbo, maame_carrier-Edge_Cuts.gm1, maame_carrier-F_Cu.gtl, maame_carrier-F_Mask.gts, maame_carrier-F_Paste.gtp]
2026-10-27 CPL rotations normalised to 0-360
    [maame_carrier_CPL_JLC.csv]
2026-10-27 3D: Pi socket shows as 2x20 female 8.5 mm (stock PinSocket model), hand-solder headers no longer DNP (excluded from BOM/CPL instead) so they render, J13/J17 header models added
    [maame_carrier.kicad_pcb, maame_carrier.kicad_sch]
2026-10-27 Board named MaameDrone V1.0: silkscreen, title blocks (rev 1.0), notes; fab outputs renamed MaameDrone_V1.0_*
    [MaameDrone_V1.0_BOM_JLC.csv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]
2026-10-28 Remove 12 V buck (U3, L2, D10, C9-C15, R12-R16, D11, J22) and 9 V output (J21); J25 pin 1 no net (9V DO NOT WIRE); F1 back to 2 A 1812 (C960026); re-routed, DRC/ERC 0 errors; fab regenerated
    [MaameDrone_V1.0_BOM_JLC.csv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]
2026-10-28 Pi socket silkscreen: GPIO name at every pin (Pi pinout), 1/2 and 39/40 end numbers, PIN 1 marker, SD CARD and USB/HDMI sides; renders PDF; fab regenerated
    [maame_carrier-B_Cu.gbl, maame_carrier-B_Mask.gbs, maame_carrier-B_Paste.gbp, maame_carrier-B_Silkscreen.gbo, maame_carrier-Edge_Cuts.gm1, maame_carrier-F_Cu.gtl, maame_carrier-F_Mask.gts, maame_carrier-F_Paste.gtp]
2026-10-28 Pi mounts face up with header soldered on its underside (pins down); not a Pi Zero WH. Silkscreen note + assembly notes fixed; fab regenerated
    [maame_carrier-B_Cu.gbl, maame_carrier-B_Mask.gbs, maame_carrier-B_Paste.gbp, maame_carrier-B_Silkscreen.gbo, maame_carrier-Edge_Cuts.gm1, maame_carrier-F_Cu.gtl, maame_carrier-F_Mask.gts, maame_carrier-F_Paste.gtp]
2026-10-28 Pi mounts FACE DOWN (header on top of Pi, as on a Zero WH): U1 footprint mirrored along the header axis (pin 1 at the right end, SD right, USB/HDMI rear); Pi silkscreen redone; re-routed, DRC/ERC 0 e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
    [MaameDrone_V1.0_BOM_JLC.csv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]
2026-10-28 ASSEMBLY_NOTES: pin 1 row is the one nearer the rear edge
2026-10-28 JLC BOM: one line per LCSC part (J23,J24,J25 together; F1,F2 together) so J25 matches; 24 lines, all with LCSC
    [MaameDrone_V1.0_BOM_JLC.csv]
2026-10-28 JLC assembles SMD only: J1, J23-J25 and U1 Pi socket moved to hand-solder (excluded from BOM/CPL, still in 3D); 32 parts / 21 BOM lines; parts-to-buy list in ASSEMBLY_NOTES
    [MaameDrone_V1.0_BOM_JLC.csv, maame_carrier.kicad_pcb, maame_carrier.kicad_sch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]
2026-10-28 Hand-solder BOM (through-hole parts to buy, LCSC numbers)
    [MaameDrone_V1.0_BOM_hand_solder.csv]
2026-11-06 MkDocs site: home, board tour, assembly and fabrication pages with detail images; ignore site/ build output and .DS_Store
    [MaameDrone_V1.0_BOM_JLC.csv, MaameDrone_V1.0_BOM_hand_solder.csv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]
2026-11-06 companion: Pi startup software (checks, LED test, companion link, systemd unit) copied from the Pi into version control
2026-11-06 companion: mavlink-router owns the FC UART (UDP 14551 companion, UDP 14550 Wi-Fi GCS, TCP 5760); startup check accepts the router holding serial0; companion service starts after the router
2026-11-06 companion: GCS ready handshake - COMMAND_LONG MAV_CMD_USER_2 to comp 191 sets the Pi ACTIVE/STANDBY after its own checks (FC alive, battery known and not low), with COMMAND_ACK and STATUSTEXT
2026-11-07 companion: Pi health to the GCS - CPU temp, load, Wi-Fi dBm, throttled/under-voltage bits and router state as NAMED_VALUE_FLOAT (PI_*) every 2 s; readers never raise so the gate heartbeat is never at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
2026-11-07 companion: camera stream - MediaMTX rpiCamera -> rtsp://maame.local:8554/cam (720p25, 1.5 Mbit/s hardware H.264, focus locked at infinity); service runs at low CPU priority so it cannot starve the ga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
2026-11-07 companion: phone/tablet dashboard served by the Pi (http://maame.local:8080)
    Mode, motors, battery, GPS, height, distance home, mission step, Pi state and
    messages, refreshed every second, no internet needed. Commands: Pause (BRAKE),
    Return home, Land only - arm/launch/kill stay on the laptop. Never sends a
    heartbeat and uses sysid 254 so it cannot mask the laptop's GCS-lost failsafe;
    PIN on every request (open hotspot); commands signed when the key exists.
    Unit + HTTP tests; SITL: state fills, Land changes the FC mode, zero heartbeats.
    [maame_dashboard.py, test_maame_dashboard.py]
2026-11-07 docs: ground station operations guide - links, connecting, pre-flight cards, hover test, coordinates missions, emergency controls, phone dashboard, flight logs, turning on signing (with USB recovery)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
2026-11-07 dashboard: start signing on the FC's first heartbeat (seeded from its timestamp); refuse commands with 503 until then
    Set up before any message arrived, pymavlink's signed commands were ignored by
    the real FC once signing was on. Verified on Maame with signing on: dashboard
    Land switched the FC to LAND (disarmed), then restored.
2026-11-07 sitl: Maame simulator tests in the repo + one-command Pi update
    sitl/run_tests.py runs launch/emergency, hover (1 m, 0.5 m), signing, dashboard and
    cockpit tests, each on a fresh ArduCopter SITL with this repo's gate and Pi code
    (all 6 pass, ~7 min). SITL's SERIAL3 is the simulated GPS, so the extra port is
    SERIAL4; tests flush before their hard exit. companion/deploy.sh updates the Pi
    (refuses while armed, backs up, compiles before restarting, records VERSION, fails
    fast when the Pi is unreachable). Guide: cockpit, vibration, updating and testing.
    [copter.parm, maame.parm]
2026-11-08 companion: camera stream status (PI_CAM) and a view-only dashboard PIN
    maame_status reports PI_CAM (mediamtx running). The dashboard accepts an optional
    second PIN (/etc/maame/dashboard-view-pin) that can watch but never command: the
    page hides the buttons and /api/cmd refuses it.
2026-11-09 companion + sitl: install missing Python packages automatically; SITL test for the props-off motor vibration check
    - companion/startup-files/requirements.txt pins pymavlink (2.4.50, as on the Pi)
    - start-maame.sh installs what is missing at start: apt for gpiozero/lgpio (root),
    pip into drone-env for pymavlink; offline it logs and carries on
    - deploy.sh copies requirements.txt and pip-installs it before restarting
    - sitl/run_tests.py creates sitl/.venv from requirements.txt when PYTHON is not set
    - sitl/tests/motor_vibe_test.py: with GPS off, DO_MOTOR_TEST is accepted per motor,
    spins exactly one output, the FC reports armed while spinning and disarms within 4 s,
    VIBRATION keeps stream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
    [motor_vibe_test.py, run_tests.py]
